versioduo/beat/hardware/README.md

# beat
🧲 4 Channel Solenoid Controller

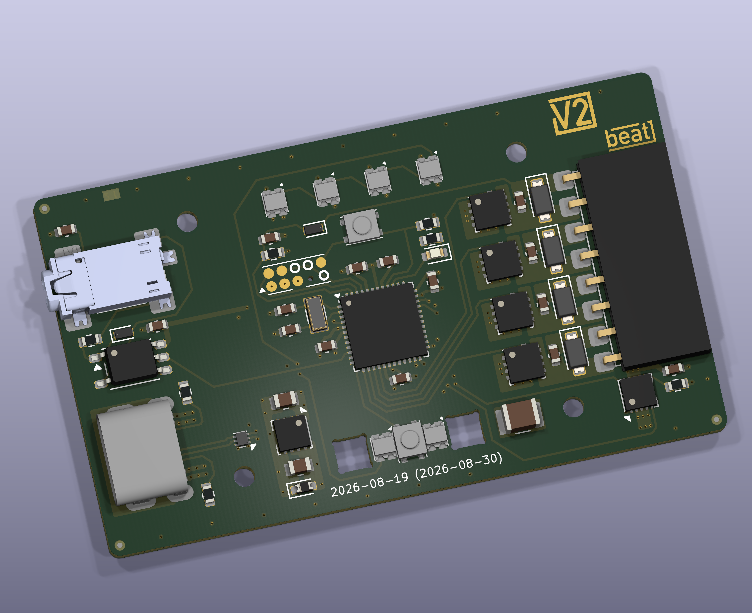
[picture p1: hardware/beat-board.png]
board


## Schematic
[PDF](beat.pdf)

## Bill Of Materials
[Interactive BOM](https://html-preview.github.io/?url=https://github.com/versioduo/beat/main/hardware-beat-bom.html)
