versioduo/beat/hardware/beat.pdf

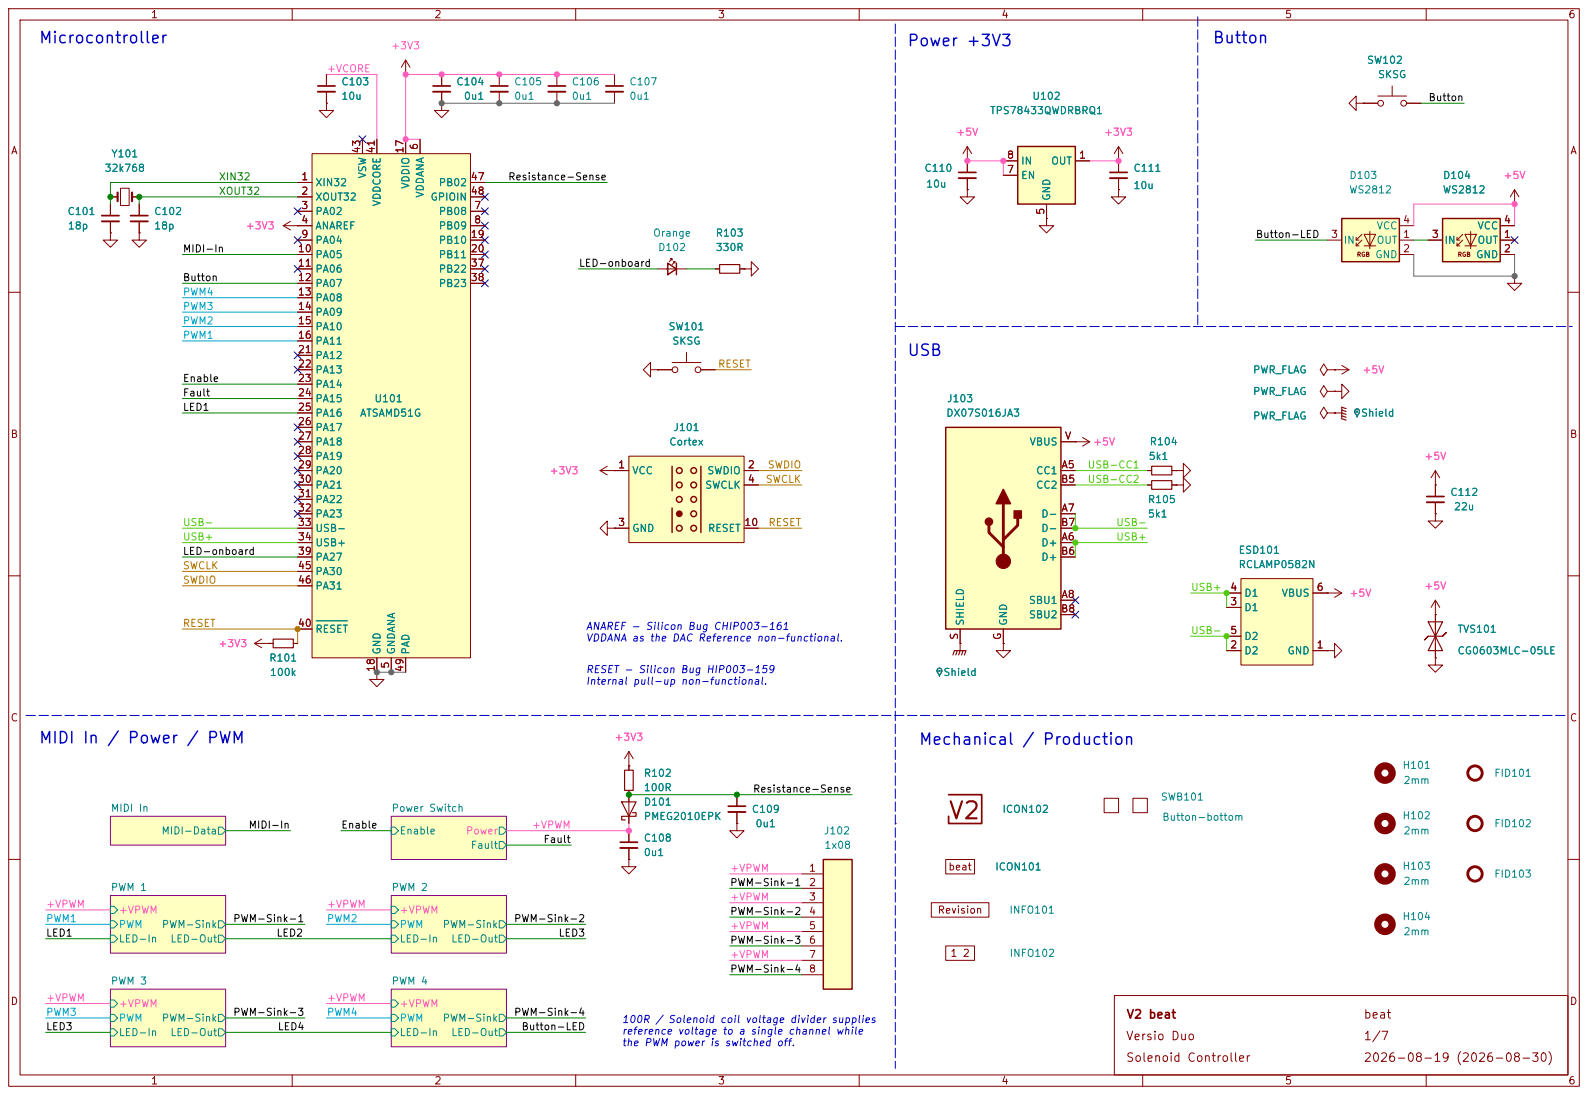
[picture p2: page 1]

VDDANA as the DAC Reference non-functional. Microcontroller

Internal pull-up non-functional. ANAREF - Silicon Bug CHIP003-161

the PWM power is switched off. MIDI In / Power / PWM

beat MIDI-Data MIDI In

PWM-Sink PWM 2 PWM

LED-In LED-Out +VPWM
PWM-Sink PWM 3 PWM

PWM-Sink PWM 4 PWM

100R / Solenoid coil voltage divider supplies
reference voltage to a single channel while

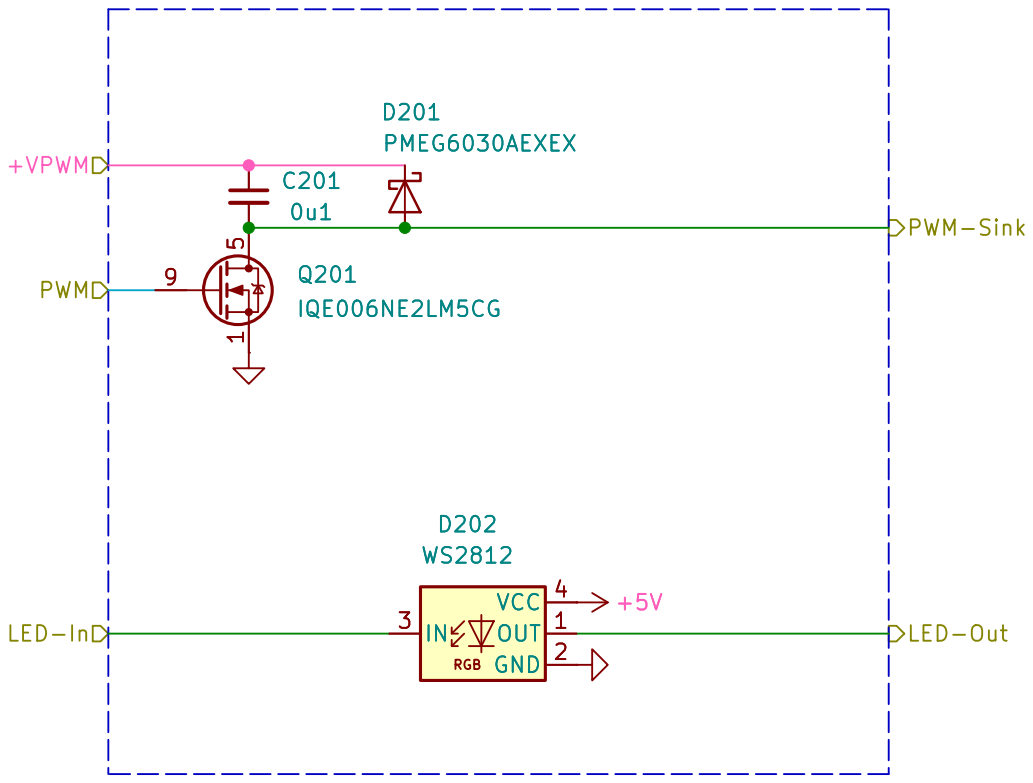
[picture p3: page 2]

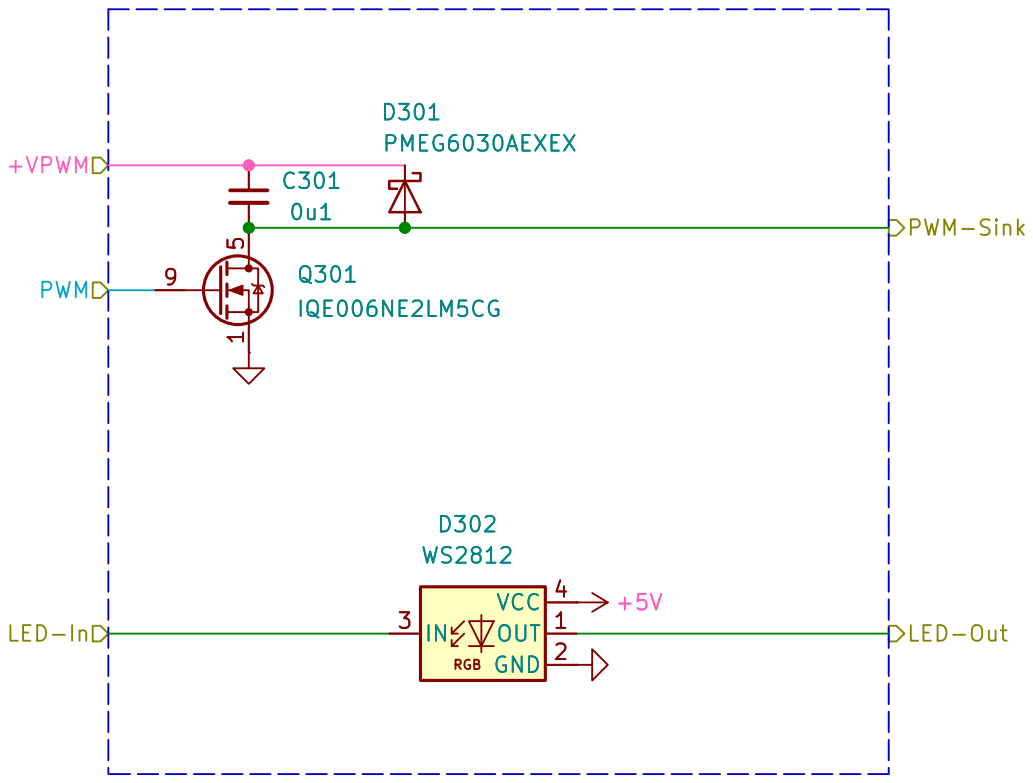
[picture p4: page 3]

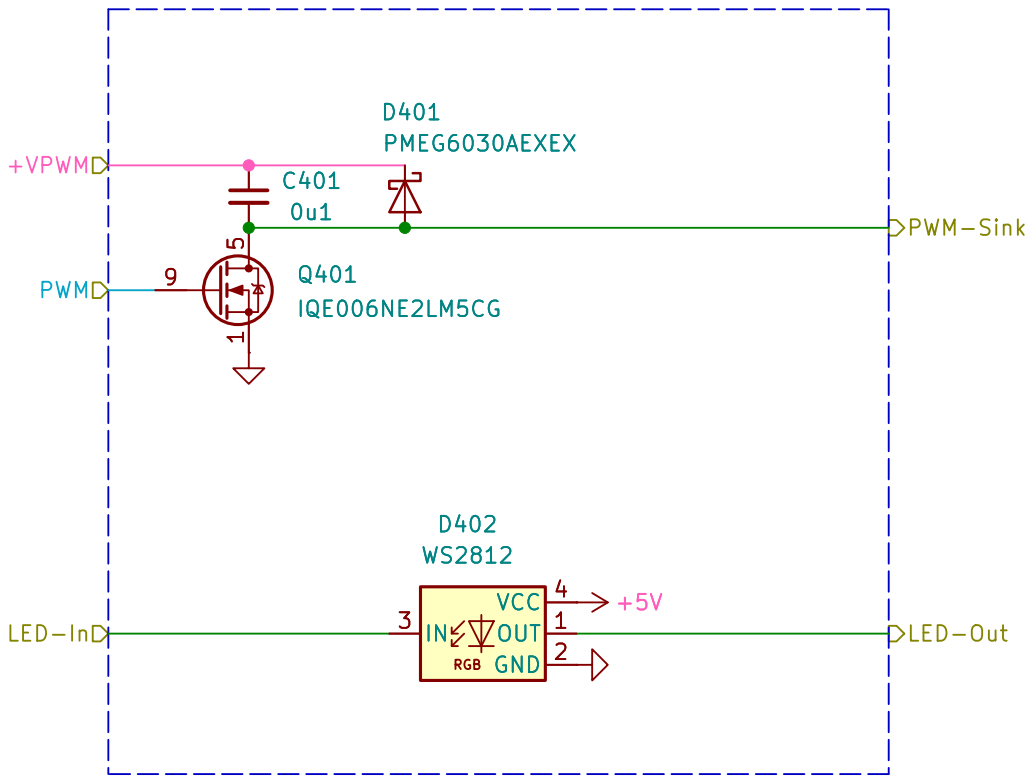
[picture p5: page 4]

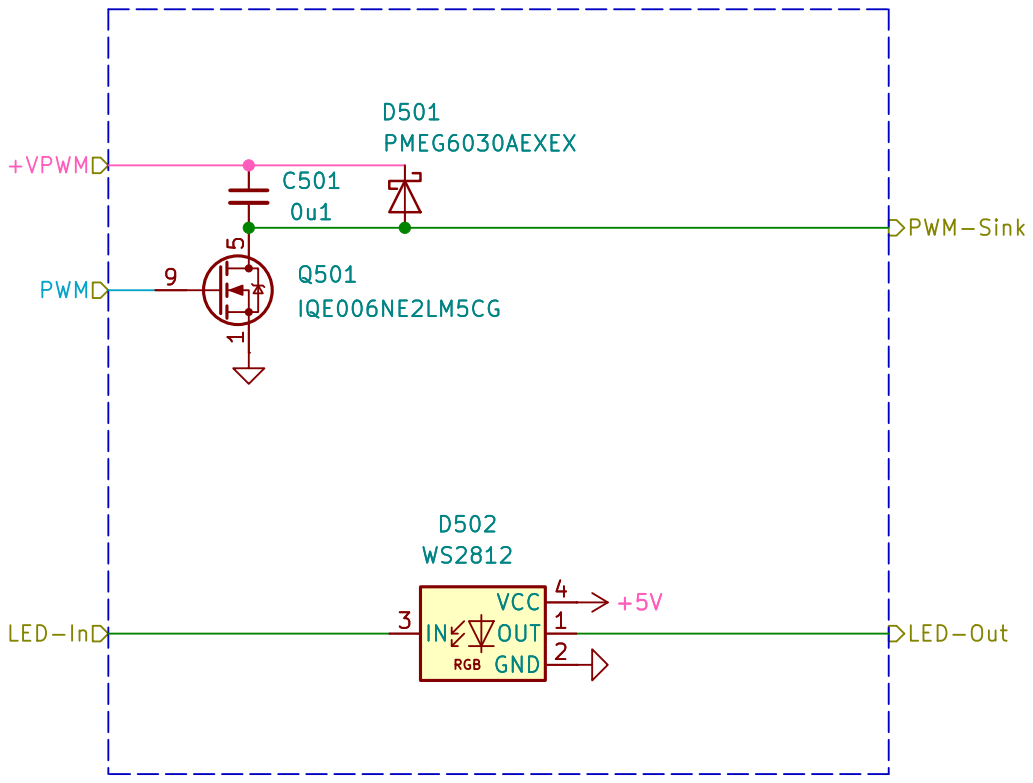
[picture p6: page 5]

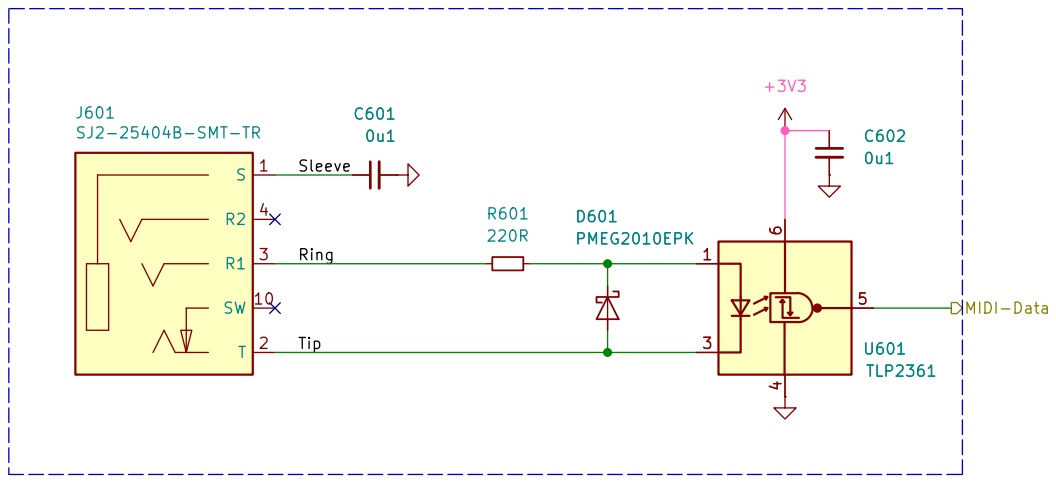
[picture p7: page 6]

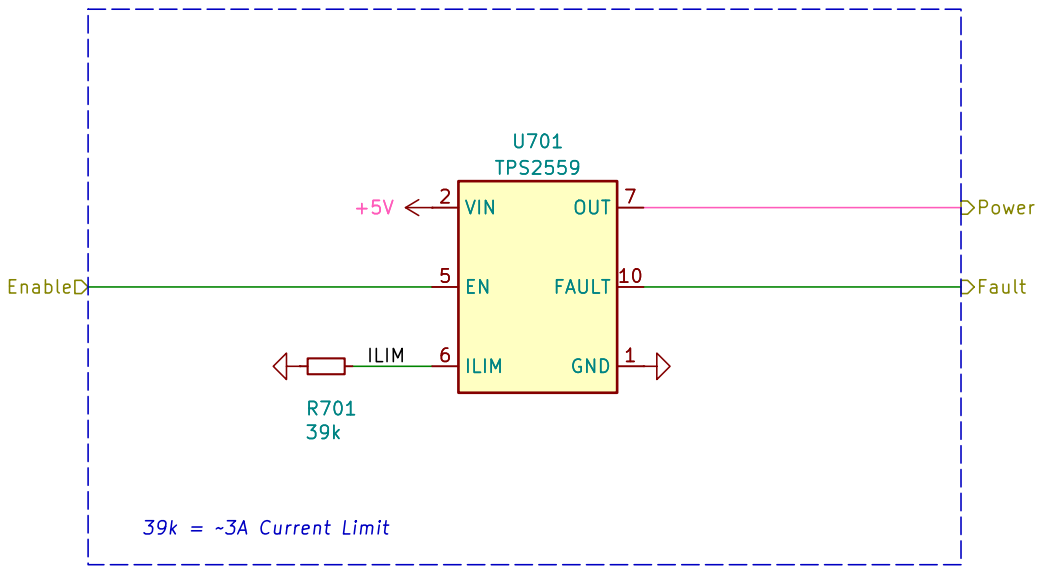
[picture p8: page 7]
