versioduo/beat/hardware/beat.kicad_pcb

## KiCad design hardware/beat.kicad_pcb (2026-08-30)

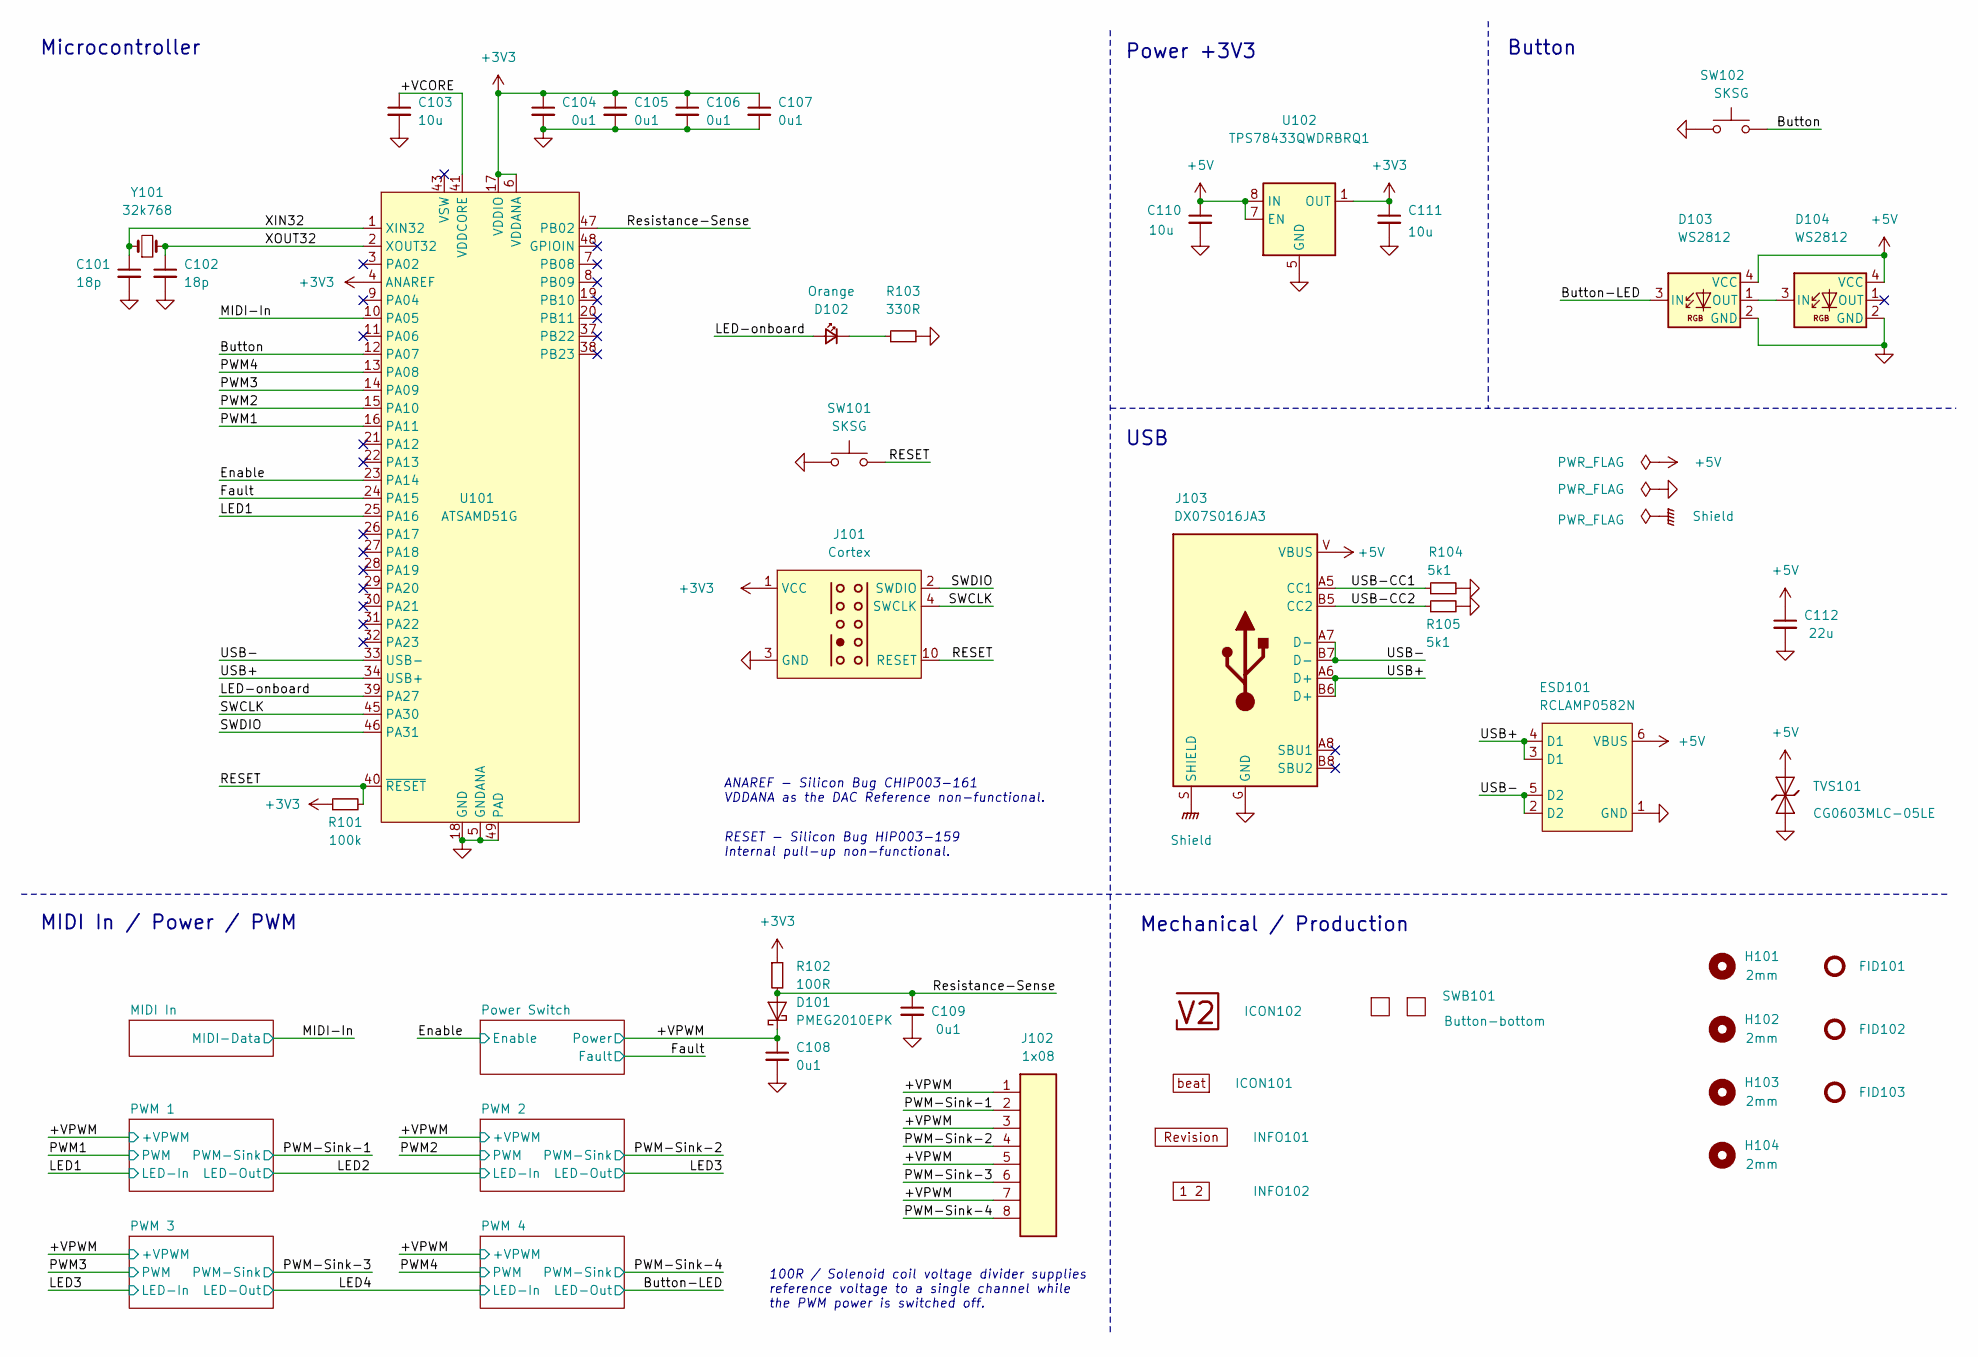
[picture p9: schematic beat.kicad_sch, V2 beat]

Parts:
C101, C102: 18p; C_1608; Rating 50V; Mouser 810-CGA3E2C0G1H180J
C103: 10u; C_1608; Rating 10V; Mouser 810-C1608X6S1A106M
C104, C105, C106, C107, C108, C109: 0u1; C_1608; Rating 50V; Mouser 810-CGA3E2X7R1H104MA
C110, C111: 10u; C_2012; Rating 25V; Mouser 810-C2012X5R1E106K
C112: 22u; C_3225; Rating 25V; Mouser 810-CGA6P3X7R1E226M5
D101: PMEG2010EPK; D_SOD-1608; Rating 20V; Mouser 771-PMEG2010EPK
D102: Orange; LED_1608; Rating 605nm; Mouser 755-SML-D12D1WT86
D103, D104: WS2812; WS2812-2020; Rating 15mA; LCSC C965555
ESD101: RCLAMP0582N; SLP1210N6; Rating 20kV; Mouser 947-RCLAMP0582N.TCT
FID101, FID102, FID103: Fiducial_Paste; Fiducial_0.5mm_Mask1mm_Paste
H101, H102, H103, H104: 2mm; MountingHole_2mm
ICON101: Board_axis; Board_beat_Small
ICON102: V2-logo; Logo_Small
INFO101: Revision
INFO102: Layer_Numbers-4
J101: Cortex
J102: 1x08; SocketHeader_1x08_P2.54mm_Horizontal
J103: DX07S016JA3; JAE_DX07S016JA3; Rating USB2.0; Mouser 656-DX07S016JA3R1500
R101: 100k; R_1608; Rating 100mW; Mouser 71-CRCW0603100KFKEAC
R102: 100R; R_1608; Rating 330mW; Mouser 71-CRCW0603100RFKEAH
R103: 330R; R_1608; Rating 100mW; Mouser 71-CRCW0603330RFKEAC
R104, R105: 5k1; R_1608; Rating 100mW; Mouser 71-CRCW06035K10FKEAC
SW101, SW102: SKSG; Rating 1.6N; Mouser 688-SKSGACE010
SWB101: Button-bottom; PCB_Button-bottom
TVS101: CG0603MLC-05LE; D_1608; Rating 5V; Mouser 652-CG0603MLC-05LE
U101: ATSAMD51G; QFN-48-1EP_7x7mm_P0.5mm_EP5.45x5.45mm_ThermalVias; Rating Cortex-M4F; Mouser 556-ATSAMD51G19AMU
U102: TPS78433QWDRBRQ1; VSON-8-1_3x3mm_P0.65_EP1.65x2.4mm; Rating 300mA; Mouser 595-TPS78433QWDRBRQ1
Y101: 32k768; Crystal_SMD_3215-2Pin_3.2x1.5mm; Rating 10ppm; Mouser 815-ABS0716632.768KT

Connections:
+3V3: C104.1, C105.1, C106.1, C107.1, C111.1, J101.1 (VCC), R101.1, R102.1, U101.4 (ANAREF), U101.6 (VDDANA), U101.17 (VDDIO), U101.36 (VDDIO), U101.44 (VDDIO), U102.1 (OUT); also elsewhere on the board
+5V: C110.1, C112.1, D103.4 (VCC), D104.4 (VCC), ESD101.6 (VBUS), J103.V (VBUS), TVS101.2 (A), U102.6 (EN), U102.7 (EN), U102.8 (IN); also elsewhere on the board
/+VCORE: C103.1, U101.41 (VDDCORE)
/+VPWM: C108.1, D101.1 (K), J102.1, J102.3, J102.5, J102.7; also elsewhere on the board
/Button: SW102.2, U101.12 (PA07)
/Button-LED: D103.3 (IN); also elsewhere on the board
/Enable: U101.23 (PA14); also elsewhere on the board
/Fault: U101.24 (PA15); also elsewhere on the board
/LED1: U101.25 (PA16); also elsewhere on the board
/LED-onboard: D102.2 (A), U101.39 (PA27)
/MIDI-In: U101.10 (PA05); also elsewhere on the board
/PWM1: U101.16 (PA11); also elsewhere on the board
/PWM2: U101.15 (PA10); also elsewhere on the board
/PWM3: U101.14 (PA09); also elsewhere on the board
/PWM4: U101.13 (PA08); also elsewhere on the board
/PWM-Sink-1: J102.2; also elsewhere on the board
/PWM-Sink-2: J102.4; also elsewhere on the board
/PWM-Sink-3: J102.6; also elsewhere on the board
/PWM-Sink-4: J102.8; also elsewhere on the board
/RESET: J101.10 (RESET), R101.2, SW101.2, U101.40 (~RESET)
/Resistance-Sense: C109.1, D101.2 (A), R102.2, U101.47 (PB02)
/SWCLK: J101.4 (SWCLK), U101.45 (PA30)
/SWDIO: J101.2 (SWDIO), U101.46 (PA31)
/Shield: J103.S (SHIELD)
/USB+: ESD101.3 (D1), ESD101.4 (D1), J103.A6 (D+), J103.B6 (D+), U101.34 (USB+)
/USB-: ESD101.2 (D2), ESD101.5 (D2), J103.A7 (D-), J103.B7 (D-), U101.33 (USB-)
/USB-CC1: J103.A5 (CC1), R104.1
/USB-CC2: J103.B5 (CC2), R105.1
/XIN32: C101.1, U101.1 (XIN32), Y101.1
/XOUT32: C102.1, U101.2 (XOUT32), Y101.2
GND: C101.2, C102.2, C103.2, C104.2, C105.2, C106.2, C107.2, C108.2, C109.2, C110.2, C111.2, C112.2, D103.2 (GND), D104.2 (GND), ESD101.1 (GND), J101.3 (GND), J101.5 (GND), J103.G (GND), R103.2, R104.2, R105.2, SW101.1, SW102.1, TVS101.1 (K), U101.5 (GNDANA), U101.18 (GND), U101.35 (GND), U101.42 (GND), U101.49 (PAD), U102.5 (GND), U102.9 (GND); also elsewhere on the board
unnamed: D102.1 (K), R103.1
unnamed: D103.1 (OUT), D104.3 (IN)

Notes on the sheet:
ANAREF -  Silicon Bug CHIP003-161 VDDANA as the DAC Reference non-functional.
MIDI In / Power / PWM
RESET -  Silicon Bug HIP003-159 Internal pull-up non-functional.
Button
100R / Solenoid coil voltage divider supplies reference voltage to a single channel while the PWM power is switched off.
Power +3V3
Mechanical / Production
Microcontroller
USB

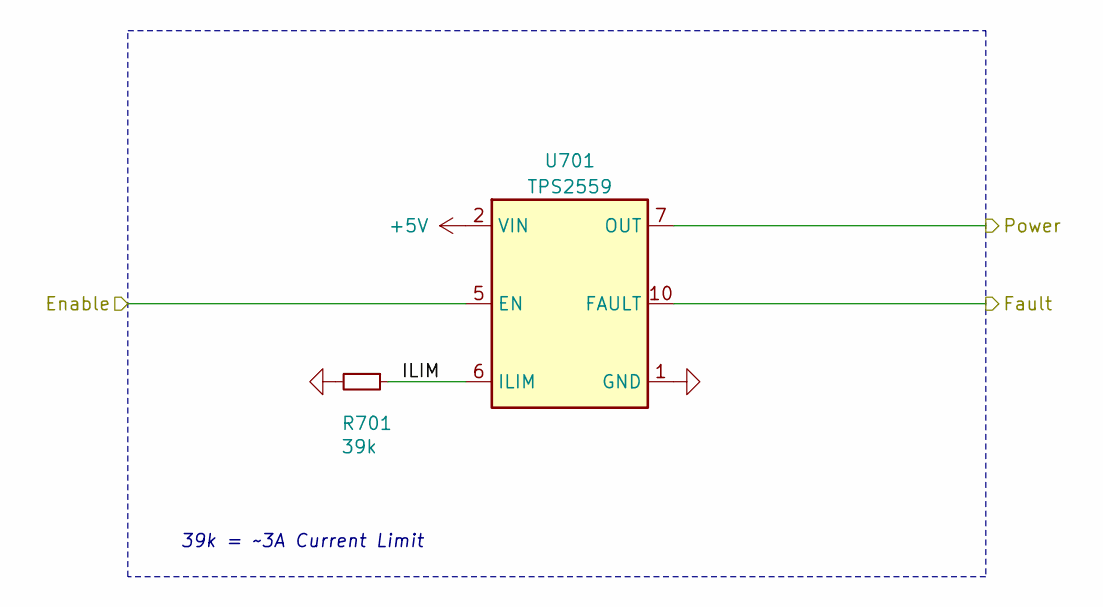
[picture p10: schematic Power-Switch.kicad_sch, V2 beat]

Parts:
R701: 39k; R_1608; Rating 500mW; Mouser 71-RCS060339K0FKEA
U701: TPS2559; VSON-10-1EP_3x3mm_P0.5mm_EP1.65x2.4mm_ThermalVias; Rating 4.7A; Mouser 595-TPS2559DRCR

Connections:
+5V: U701.2 (VIN), U701.3 (VIN), U701.4 (VIN); also elsewhere on the board
/+VPWM: U701.7 (OUT), U701.8 (OUT), U701.9 (OUT); also elsewhere on the board
/Enable: U701.5 (EN); also elsewhere on the board
/Fault: U701.10 (FAULT); also elsewhere on the board
/Power Switch/ILIM: R701.1, U701.6 (ILIM)
GND: R701.2, U701.1 (GND), U701.11 (GND); also elsewhere on the board

Notes on the sheet:
39k = ~3A Current Limit

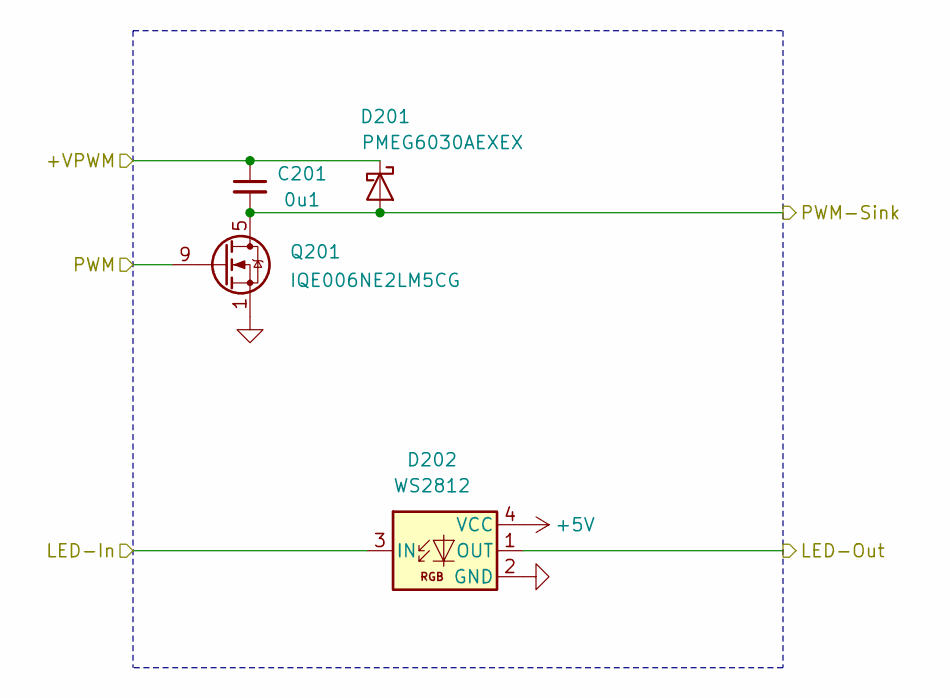
[picture p11: schematic PWM-Channel.kicad_sch, V2 beat]

Parts:
C201: 0u1; C_1608; Rating 50V; Mouser 810-CGA3E2X7R1H104MA
D201: PMEG6030AEXEX; D_SOD-123HP; Rating 60V; Mouser 771-PMEG6030AEXEX
D202: WS2812; WS2812-2020; Rating 15mA; LCSC C965555
Q201: IQE006NE2LM5CG; WHTFN-9; Rating 25V; Mouser 726-IQE006NE2LM5CGAT

Connections:
+5V: D202.4 (VCC); also elsewhere on the board
/+VPWM: C201.1, D201.1 (K); also elsewhere on the board
/LED1: D202.3 (IN); also elsewhere on the board
/LED2: D202.1 (OUT); also elsewhere on the board
/PWM1: Q201.9 (G); also elsewhere on the board
/PWM-Sink-1: C201.2, D201.2 (A), Q201.5 (D); also elsewhere on the board
GND: D202.2 (GND), Q201.1 (S); also elsewhere on the board

Parts of its further copies:
C301, C401, C501: 0u1; C_1608; Rating 50V; Mouser 810-CGA3E2X7R1H104MA
D301, D401, D501: PMEG6030AEXEX; D_SOD-123HP; Rating 60V; Mouser 771-PMEG6030AEXEX
D302, D402, D502: WS2812; WS2812-2020; Rating 15mA; LCSC C965555
Q301, Q401, Q501: IQE006NE2LM5CG; WHTFN-9; Rating 25V; Mouser 726-IQE006NE2LM5CGAT

Connections of its further copies:
+5V: D302.4 (VCC), D402.4 (VCC), D502.4 (VCC); also elsewhere on the board
/+VPWM: C301.1, C401.1, C501.1, D301.1 (K), D401.1 (K), D501.1 (K); also elsewhere on the board
/Button-LED: D502.1 (OUT); also elsewhere on the board
/LED2: D302.3 (IN); also elsewhere on the board
/LED3: D302.1 (OUT), D402.3 (IN)
/LED4: D402.1 (OUT), D502.3 (IN)
/PWM2: Q301.9 (G); also elsewhere on the board
/PWM3: Q401.9 (G); also elsewhere on the board
/PWM4: Q501.9 (G); also elsewhere on the board
/PWM-Sink-2: C301.2, D301.2 (A), Q301.5 (D); also elsewhere on the board
/PWM-Sink-3: C401.2, D401.2 (A), Q401.5 (D); also elsewhere on the board
/PWM-Sink-4: C501.2, D501.2 (A), Q501.5 (D); also elsewhere on the board
GND: D302.2 (GND), D402.2 (GND), D502.2 (GND), Q301.1 (S), Q401.1 (S), Q501.1 (S); also elsewhere on the board

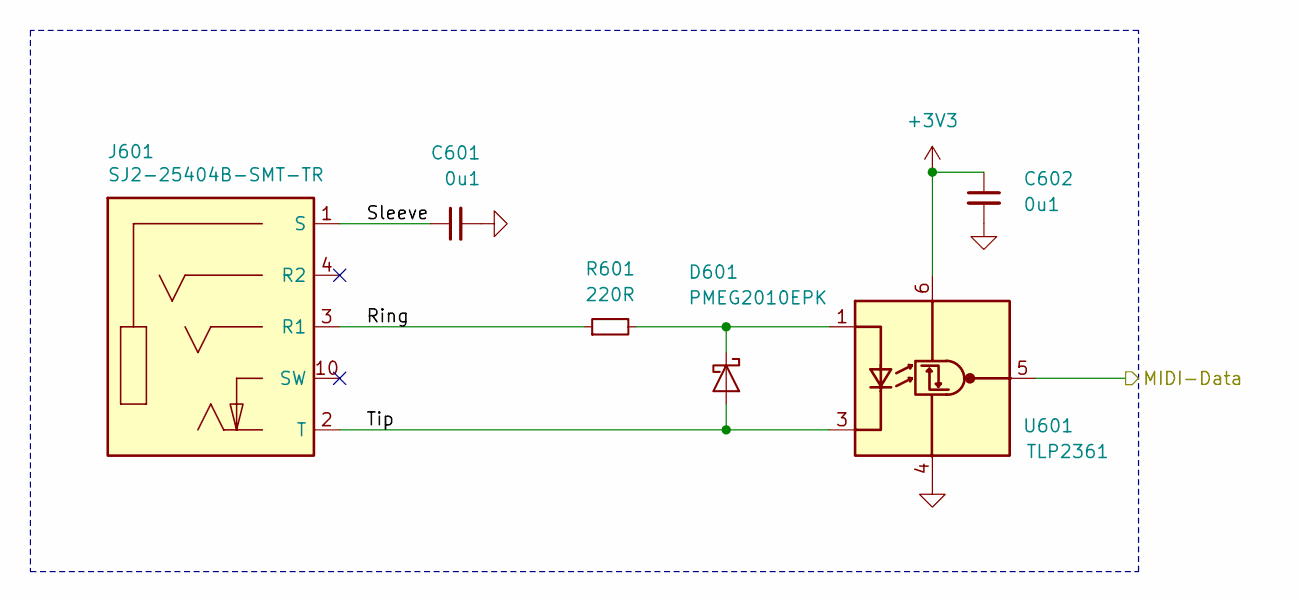
[picture p12: schematic MIDI-In.kicad_sch, V2 beat]

Parts:
C601, C602: 0u1; C_1608; Rating 50V; Mouser 810-CGA3E2X7R1H104MA
D601: PMEG2010EPK; D_SOD-1608; Rating 20V; Mouser 771-PMEG2010EPK
J601: SJ2-25404B-SMT-TR; CUI_SJ2-25404B-SMT-TR; Rating 2.5mm; Mouser 490-SJ2-25404BSMT-TR
R601: 220R; R_1608; Rating 333mW; Mouser 667-ERJ-PA3F2200V
U601: TLP2361; SO-5-6_4.55x3.7mm_P1.27mm; Rating 15Mbps; Mouser 757-TLP2361TPRE

Connections:
+3V3: C602.1, U601.6 (VDD); also elsewhere on the board
/MIDI In/Ring: J601.3 (R1), R601.1
/MIDI In/Sleeve: C601.1, J601.1 (S)
/MIDI In/Tip: D601.2 (A), J601.2 (T), U601.3 (K)
/MIDI-In: U601.5 (VO); also elsewhere on the board
GND: C601.2, C602.2, U601.4 (GND); also elsewhere on the board
unnamed: D601.1 (K), R601.2, U601.1 (A)

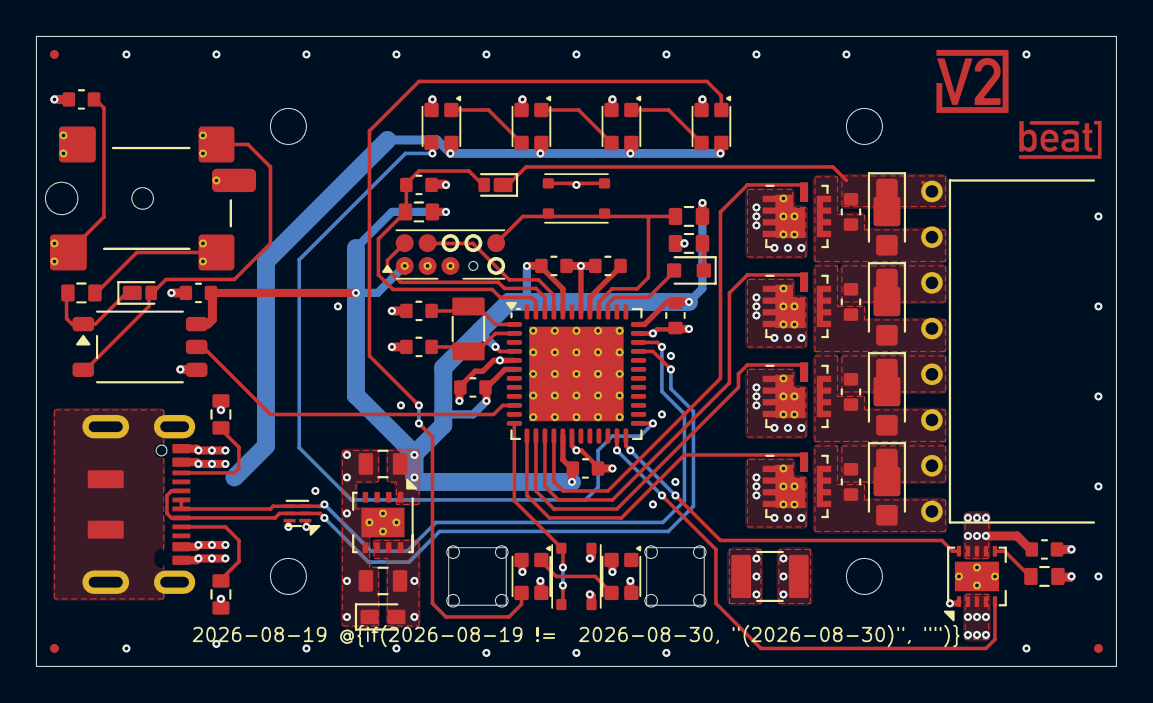
[picture p13: board beat.kicad_pcb from above]

Board: 4 copper layers, 60.0 x 35.0 mm, 67 parts (0 on the bottom side), 40 nets.
