versioduo/beat/(commit log)

2026-02-01 Update library
    [MIDIIn.kicad_sch, PWMChannel.kicad_sch, PowerSwitch.kicad_sch, beat.kicad_pcb, beat.kicad_sch]
2026-02-10 Use date as revision
    [beat.kicad_pcb, beat.kicad_sch]
2026-02-13 Replace Order_Number
    [MIDIIn.kicad_sch, PWMChannel.kicad_sch, PowerSwitch.kicad_sch, beat-cover-camp.kicad_pcb, beat-cover-camp.kicad_sch, beat-cover.kicad_pcb, beat-cover.kicad_sch, beat.kicad_pcb]
2026-03-11 Replace diode
    [MIDIIn.kicad_sch, PWMChannel.kicad_sch, PowerSwitch.kicad_sch, beat.kicad_pcb, beat.kicad_sch]
2026-03-14 Update ESD suppressor
    [PWMChannel.kicad_sch, beat.kicad_pcb, beat.kicad_sch]
2026-05-11 Good Bye Imperial
    [MIDIIn.kicad_sch, PWMChannel.kicad_sch, PowerSwitch.kicad_sch, beat.kicad_sch]
2026-08-20 Add front + back
    [MIDIIn.kicad_sch, PWMChannel.kicad_sch, PowerSwitch.kicad_sch, back.kicad_pcb, back.kicad_sch, beat-cover-camp.kicad_pcb, beat-cover-camp.kicad_sch, beat-cover.kicad_pcb]
